brianrubio7/self-balancning-robot/CAD/AdapterVariations/Motormount1.1.SLDPRT

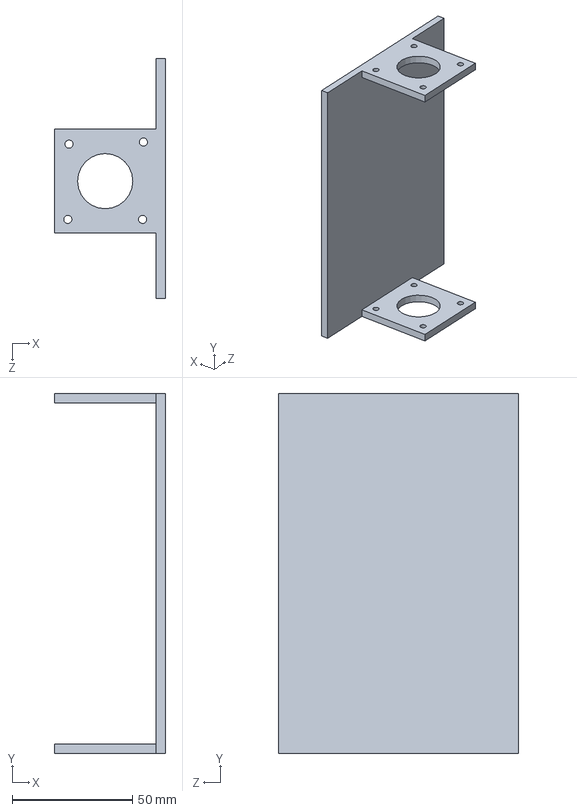
[picture p2: CAD file, 2026-06-04]
CAD/AdapterVariations/Motormount1.1.SLDPRT
46.3 x 150.0 x 100.0 mm
