brianrubio7/self-balancning-robot/CAD/AdapterVariations/RobotDShaftVFinal.SLDPRT

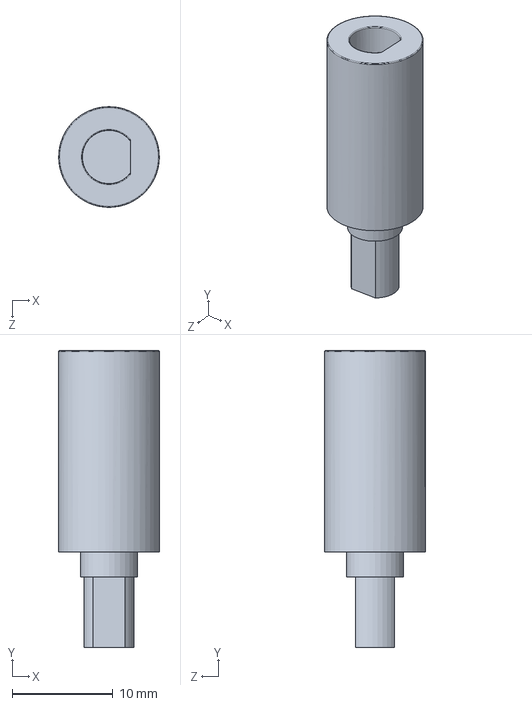
[picture p3: CAD file, 2026-06-04]
CAD/AdapterVariations/RobotDShaftVFinal.SLDPRT
10.0 x 29.5 x 10.0 mm
