brianrubio7/self-balancning-robot/CAD/AdapterVariations/Motormount1.2.SLDPRT

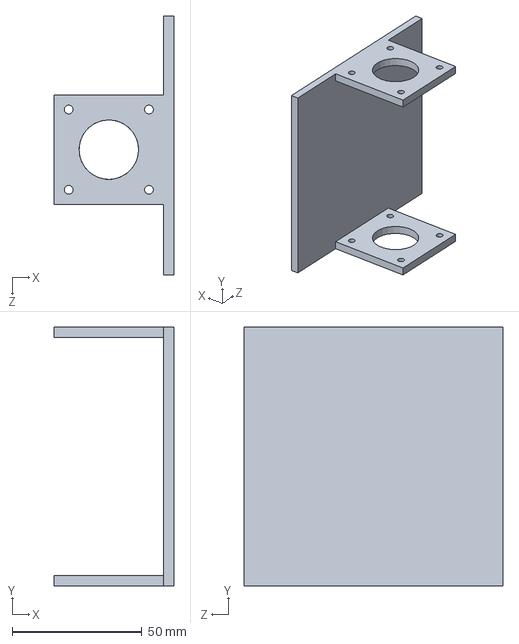
[picture p4: CAD file, 2026-06-04]
CAD/AdapterVariations/Motormount1.2.SLDPRT
46.3 x 100.0 x 100.0 mm
