brianrubio7/self-balancning-robot/CAD/AdapterVariations/Motormounts.SLDPRT

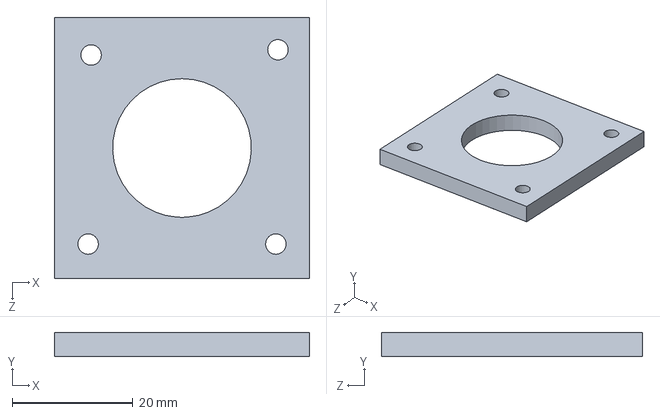
[picture p5: CAD file, 2026-06-04]
CAD/AdapterVariations/Motormounts.SLDPRT
42.3 x 4.00 x 43.3 mm
