brianrubio7/self-balancning-robot/CAD/Motormounts/Motormount1.STL

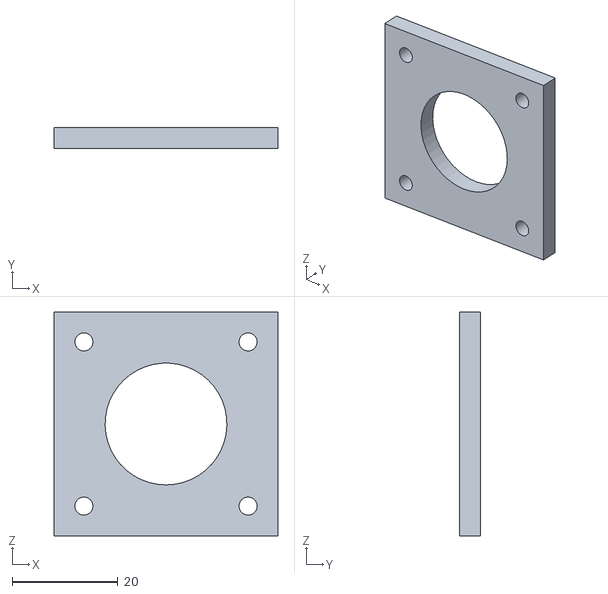
[picture p6: CAD file, 2026-06-04]
CAD/Motormounts/Motormount1.STL
42.3 x 4.00 x 42.3
