brianrubio7/self-balancning-robot/CAD/AdapterVariations/Base1.SLDPRT

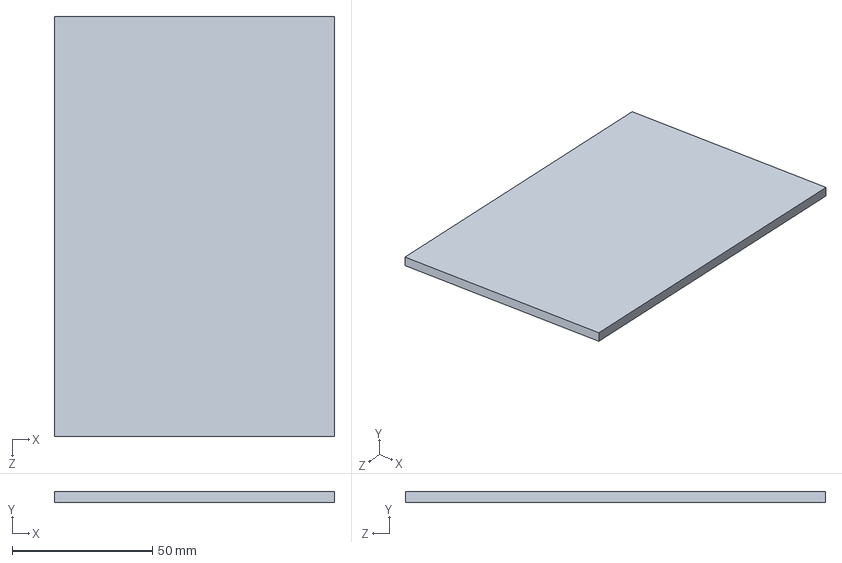
[picture p7: CAD file, 2026-06-04]
CAD/AdapterVariations/Base1.SLDPRT
100.0 x 4.00 x 150.0 mm
