brianrubio7/self-balancning-robot/(list of files, cad)

Other CAD files:
CAD/Motormounts/Motormount1.3.SLDPRT
CAD/Motormounts/Motormount1.1.STL
CAD/Motormounts/Motormount1.2.SLDPRT
CAD/AdapterVariations/RobotDShaftVFinal2.SLDPRT
CAD/AdapterVariations/RobotDShaftVFinal.STL
CAD/Motormounts/Motormount1.2.STL
CAD/Motormounts/Motormount1.3.STL
