brianrubio7/self-balancning-robot/(commit log)

2026-06-04 Renamed Arduino Sketch
2026-06-04 CAD files
    [Base1.SLDPRT, Motormount1.1.SLDPRT, Motormount1.1.STL, Motormount1.2.SLDPRT, Motormount1.2.STL, Motormount1.3.SLDPRT, Motormount1.3.STL, Motormount1.STL]
2026-06-04 Current prototype and issues
2026-06-11 Prototype V1.1 design issues and planned solutions
2026-06-14 Custom PCB Files
    [pcb.kicad_pcb, pcb.kicad_sch, pcbv1.kicad_sch]
2026-06-14 Footprints for electronics
    [pcb.kicad_sch]
2026-06-14 Footprins for electronics
    [pcb.kicad_sch]
2026-06-18 Finalized PCB version 1
    [pcb.kicad_pcb, pcb.kicad_sch]
