brianrubio7/self-balancning-robot/Images/prototype_v1.1_side.jpeg

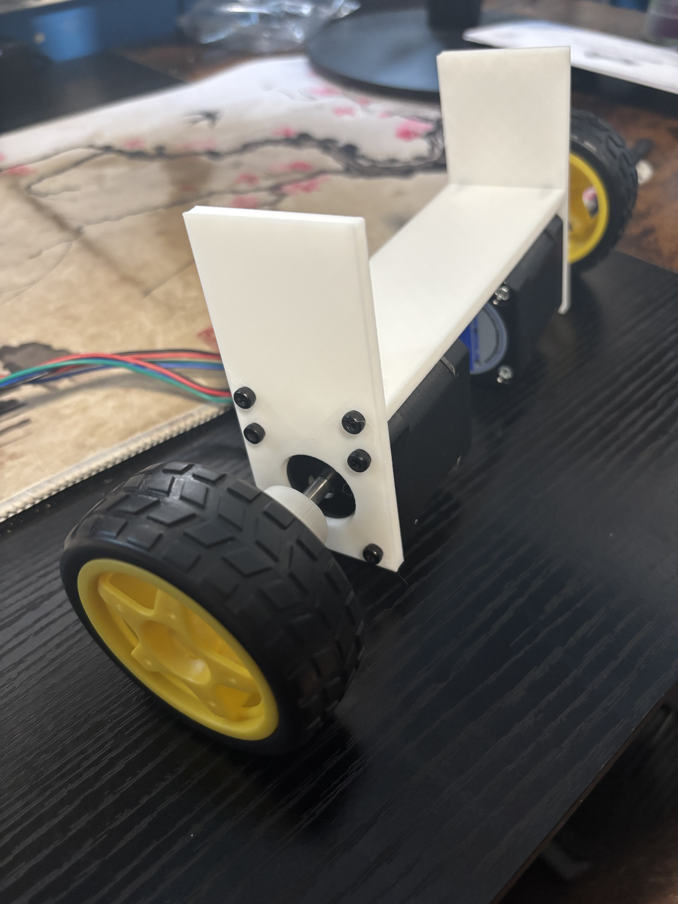
[picture p1: Images/prototype_v1.1_side.jpeg]
Images/prototype_v1.1_side.jpeg
